pbwarmu017/BIO1015-Homeostasis-Demonstrator/Images/Crank Affector Wiring.jpg

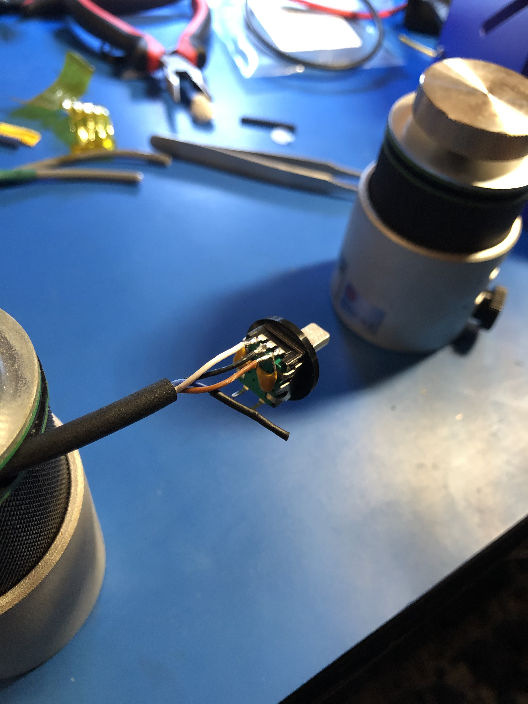
Images/Crank Affector Wiring.jpg
