pbwarmu017/BIO1015-Homeostasis-Demonstrator/Images/handcrank body assembly.jpg

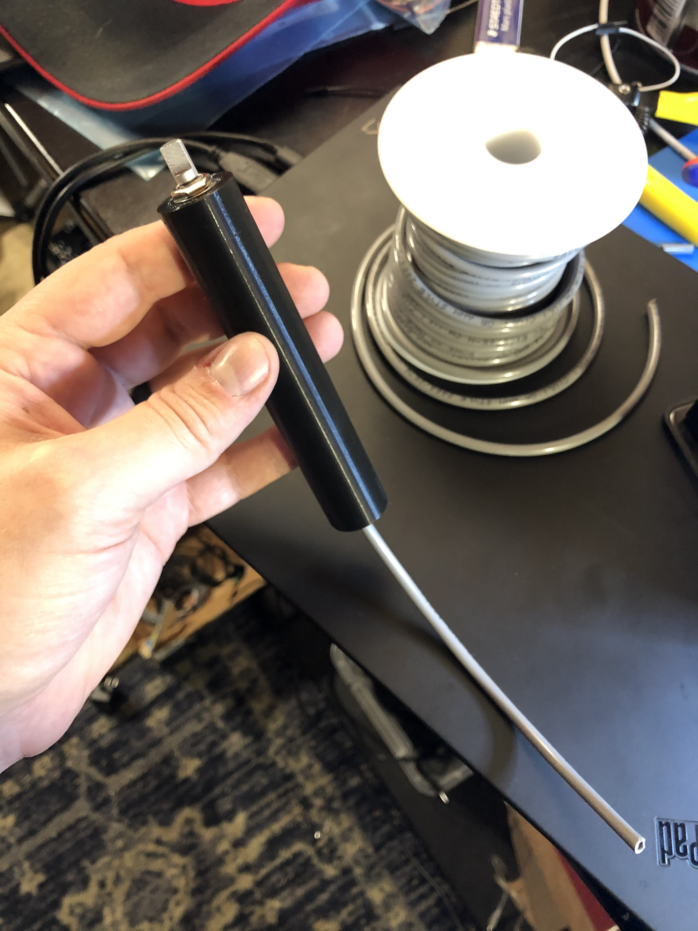
Images/handcrank body assembly.jpg
