pbwarmu017/BIO1015-Homeostasis-Demonstrator/circuits/bitmaps/top.bmp

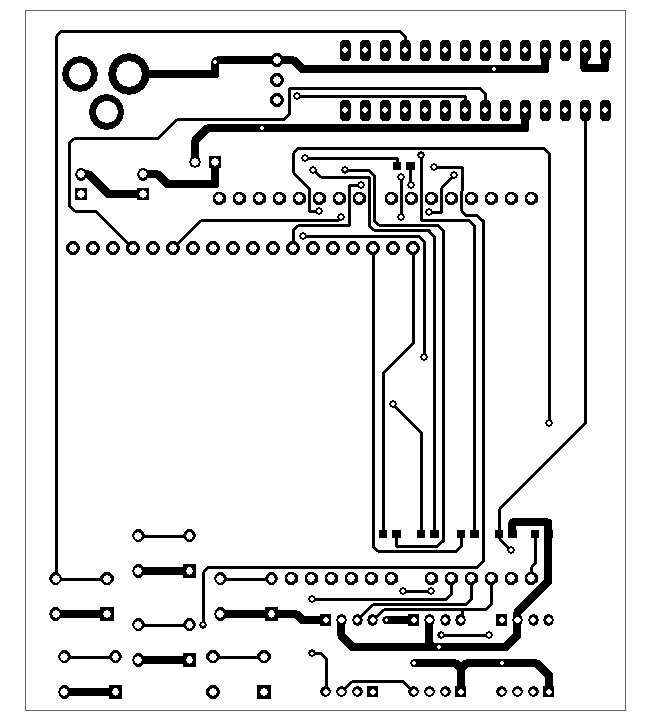
circuits/bitmaps/top.bmp
