pbwarmu017/BIO1015-Homeostasis-Demonstrator/Images/Connector Closeup.jpg

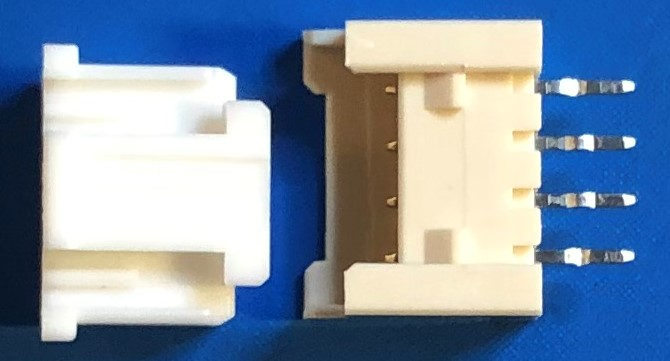
Images/Connector Closeup.jpg
