pbwarmu017/BIO1015-Homeostasis-Demonstrator/Images/Connectors.jpg

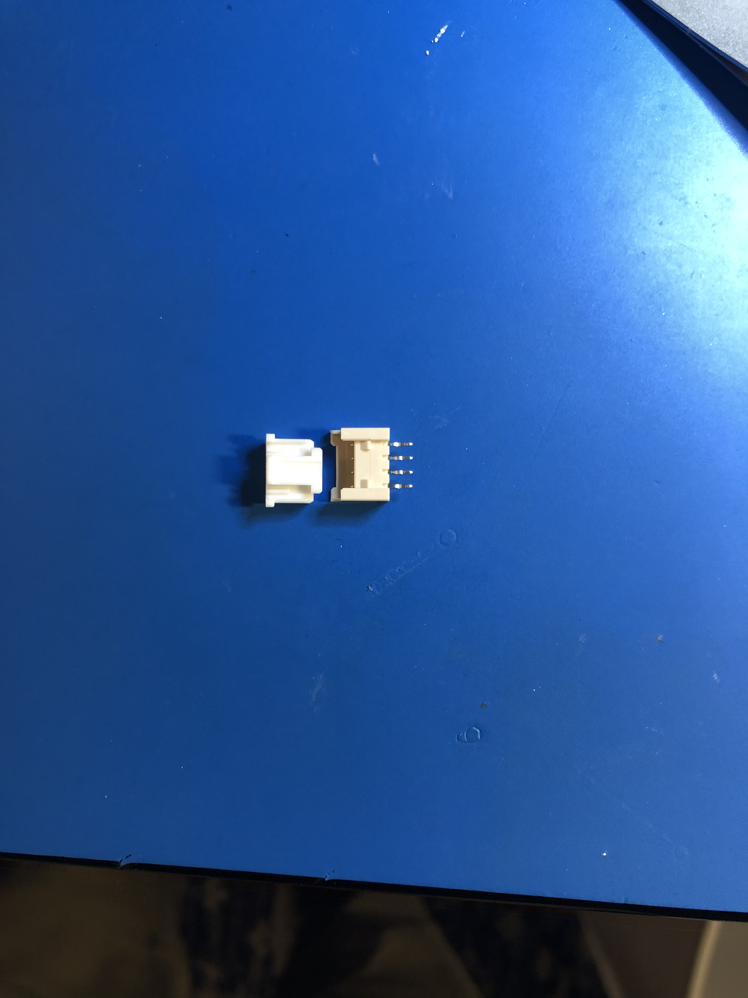
Images/Connectors.jpg
