pbwarmu017/BIO1015-Homeostasis-Demonstrator/Images/Crank Affector.jpg

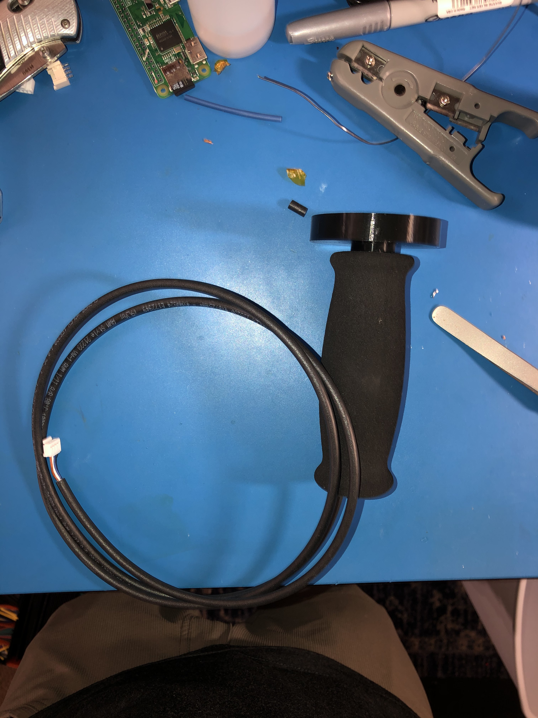
Images/Crank Affector.jpg
