pbwarmu017/BIO1015-Homeostasis-Demonstrator/Images/Grip Affector.jpg

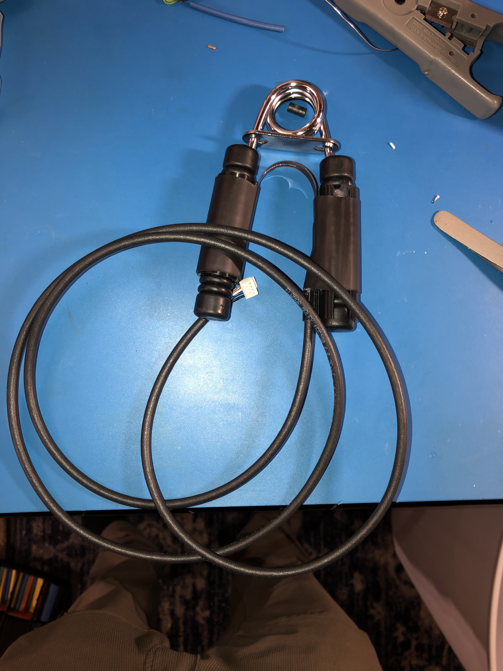
Images/Grip Affector.jpg
