pbwarmu017/BIO1015-Homeostasis-Demonstrator/Images/how caps are connected.jpg

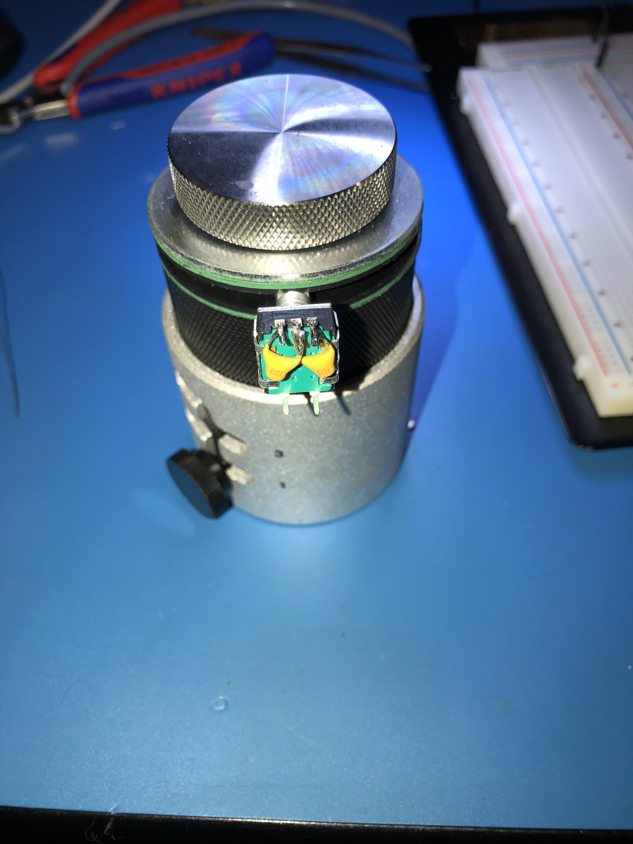
Images/how caps are connected.jpg
