pbwarmu017/BIO1015-Homeostasis-Demonstrator/Images/IMG_1912.JPEG

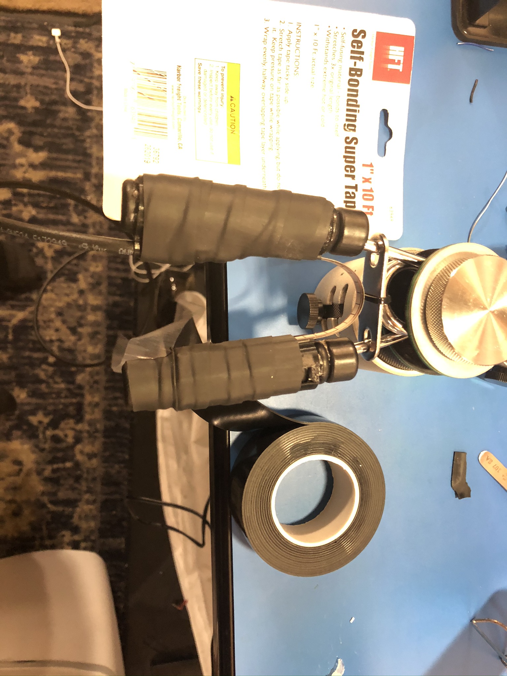
Images/IMG_1912.JPEG
