pbwarmu017/BIO1015-Homeostasis-Demonstrator/Images/IMG_1914.JPEG

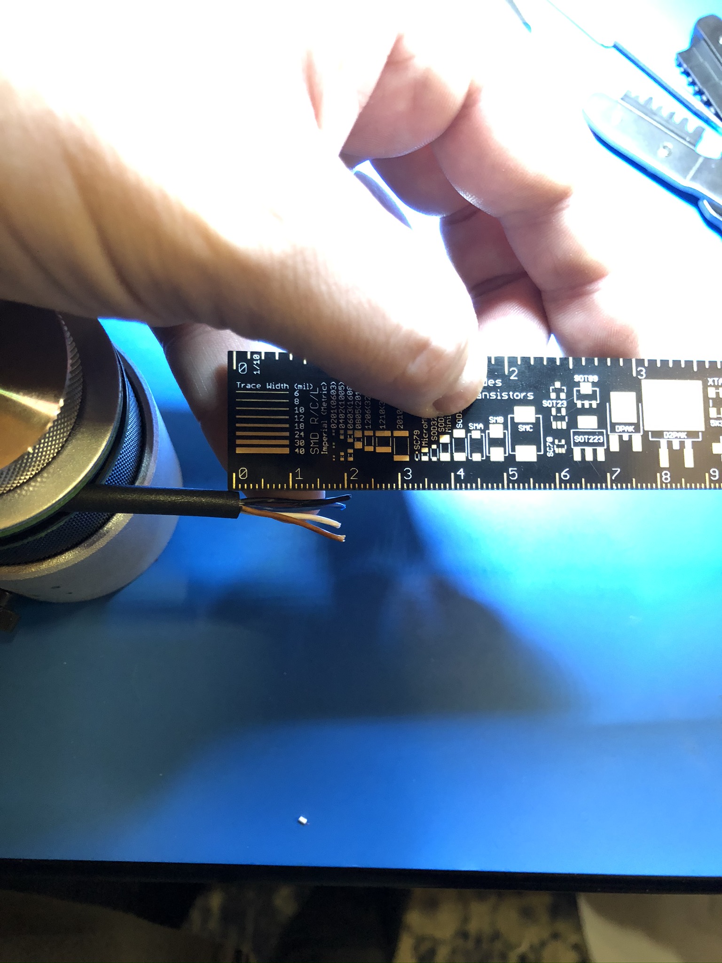
Images/IMG_1914.JPEG
