pbwarmu017/BIO1015-Homeostasis-Demonstrator/3D Models/Main Housing_v2.stl

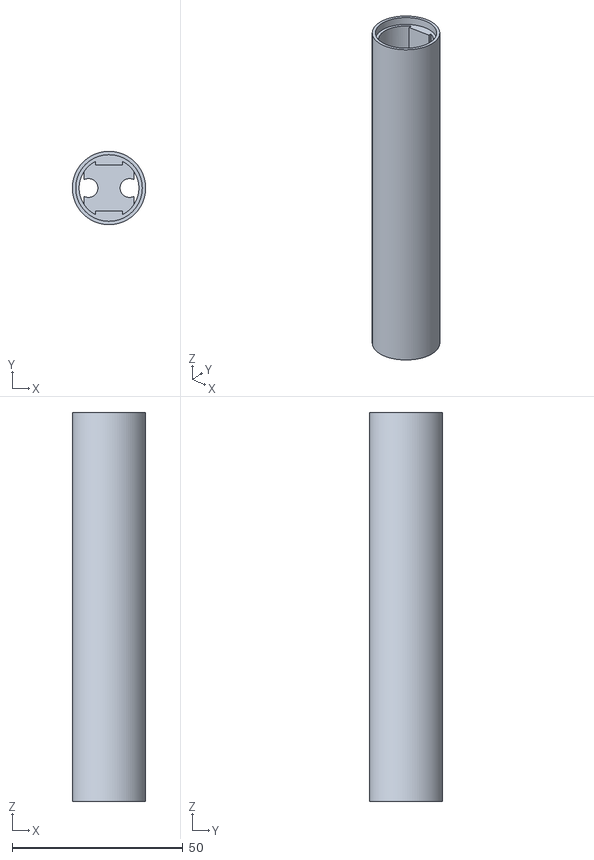
[picture p32: CAD file, 2020-02-03]
3D Models/Main Housing_v2.stl
21.5 x 21.5 x 114.0
