pbwarmu017/BIO1015-Homeostasis-Demonstrator/3D Models/Squeeze Insert w Strain Relief.stl

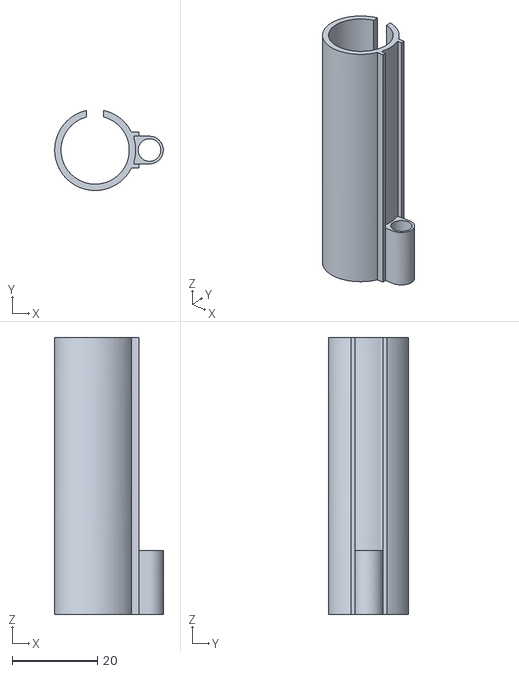
[picture p33: CAD file, 2019-11-03]
3D Models/Squeeze Insert w Strain Relief.stl
25.5 x 18.8 x 65.0
