pbwarmu017/BIO1015-Homeostasis-Demonstrator/3D Models/Squeeze Insert wo Strain Relief.stl

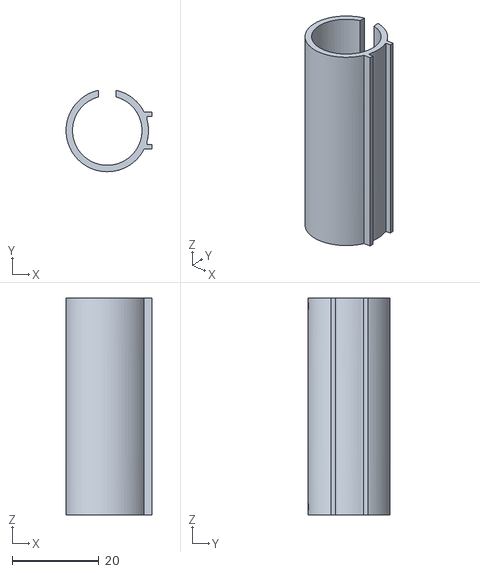
[picture p34: CAD file, 2019-11-03]
3D Models/Squeeze Insert wo Strain Relief.stl
19.8 x 18.8 x 50.0
