pbwarmu017/BIO1015-Homeostasis-Demonstrator/3D Models/HandCrank_v1.stl

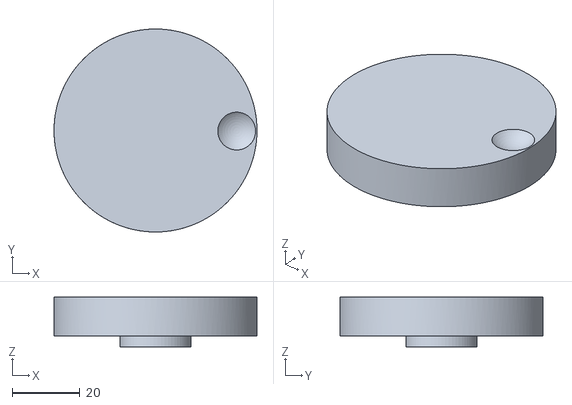
[picture p35: CAD file, 2019-10-15]
3D Models/HandCrank_v1.stl
60.0 x 60.0 x 14.8
