pbwarmu017/BIO1015-Homeostasis-Demonstrator/3D Models/Cover_v1.stl

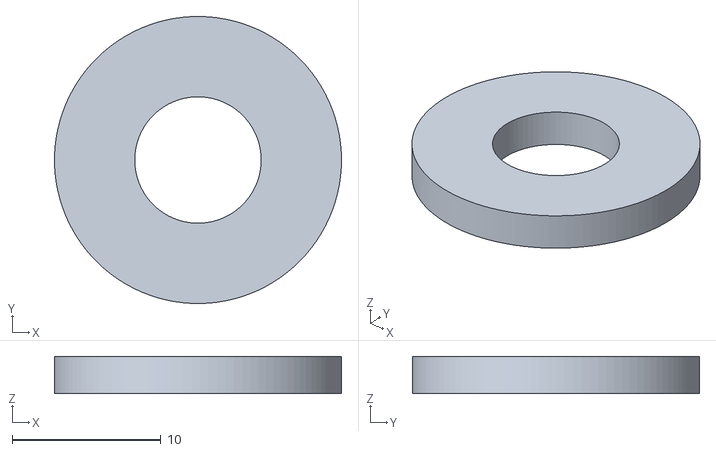
[picture p36: CAD file, 2019-10-13]
3D Models/Cover_v1.stl
19.3 x 19.3 x 2.50
