pbwarmu017/BIO1015-Homeostasis-Demonstrator/3D Models/Main Housing_v1.stl

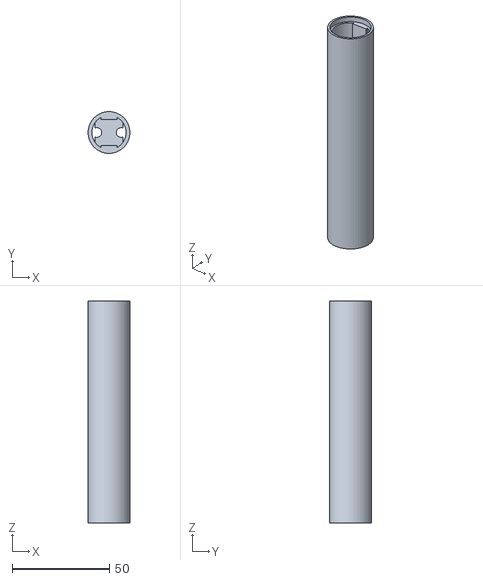
[picture p37: CAD file, 2019-10-13, an earlier design]
3D Models/Main Housing_v1.stl
21.5 x 21.5 x 114.0
