pbwarmu017/BIO1015-Homeostasis-Demonstrator/(threads)

Thread 11 (2019-10-13):

Erratic Interrupts

pbwarmu017, 2019-10-13:
https://github.com/pbwarmu017/BIO1015-Homeostasis-Demonstrator/blob/eec98f19c3d1bf28589ca5f6185262149d05f7ed/multi-effector_homeostasis_device/multi-effector_homeost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

If the code in the interrupt takes longer than 1 millisecond to complete, the interrupt will trigger again before the previous code has finished causing erratic behavior

pbwarmu017, 2019-10-13:
I need to inline the functions called within the interrupts, or  better yet... have the interrupt set a flag that the main loop checks for, and then clear the flag after it is done executing. Right now, the real world behavior of the program depends on how long it takes to execute the code from within the interrupt. If it takes longer than 1 ms, it causes problems. When fourier analysis is incorporated later on, this problem will become painfully evident.

pbwarmu017, 2019-10-14:
Decoupled function calls from the ISRs with commit 6f0d6444185b342927c01342c0557562273669da

Closed 2019-10-14.

Thread 12 (2019-10-13):

Find better cabling

pbwarmu017, 2019-10-13:
The PVC jacket on this wire is stiff, and these parts have to move freely. Find a softer wire that is reasonably priced, perhaps polyurethane?

pbwarmu017, 2019-10-13:
ordered a small sample of this:
https://www.digikey.com/product-detail/en/molex/1552300013/WM21784-1-ND/9094120
Will update later.

Thread 16 (2019-10-13):

Make another prototyping cable

pbwarmu017, 2019-10-13:
Need another one, currently only have one... but I have two affectors and I'd like to use them together.

pbwarmu017, 2019-10-13:
Completed. Made a regular connection cable and added a removable breakout to it.

Closed 2019-10-13.

Thread 3 (2019-10-13):

Hand Crank Design

pbwarmu017, 2019-10-13:
- [x] Verify hardware function (filtering needed)?
- [x] Initial Body Design
- [x] Initial Handle Design
- [x] Initial Cap Design
- [x] Test and refine body
- [x] Test and refine handle
- [x] test and refine cap

pbwarmu017, 2019-10-13:
Hardware filtering is needed. Instituted a low pass filter, and did some clever signal conditioning to debounce.

pbwarmu017, 2019-10-13:
Modified and reprinted body to make cable openings larger. may need to modify again to provide strain relief.

pbwarmu017, 2019-10-13:
Hand crank prototype completed.

Closed 2019-10-13.

Thread 5 (2019-10-13):

Hand Crank Affector

pbwarmu017, 2019-10-13:
- [x] Implement rotary encoder in software
- [x] make max rotation rate 60 hz (per datasheet)
- [x] implement moving average EFFICIENTLY
- [x] standardize the way that rates are calculated in the software to make adding new affectors easier

pbwarmu017, 2019-10-13:
further tuning will be needed in the future one the affector is fully assembled, but for now I am moving on.

Closed 2019-10-13.

Thread 6 (2019-10-13):

Connect and Activate Backlit Display

pbwarmu017, 2019-10-13:
- [x] Reverse Engineer circuit for later use in shield
- [x] wire in display to arduino
- [x] find and implement relevant software packages
- [x] test display RGB backlight
- [x] test display readout
- [x] test display buttons

pbwarmu017, 2019-10-15:
This needs to be done before the shield is manufactured to verify that all the pinouts will work with one another. Once the display is connected, and working along with the other two affectors, then start the work on designing and manufacturing the shield.

Closed 2019-10-27.

Thread 8 (2019-10-13):

Find better wiring that is more flexible.

pbwarmu017, 2019-10-13:
We need more flexible cabling. PVC isn't going to cut it.

pbwarmu017, 2019-10-13:
Ordered some Polyurethane cabling to test. Should be more flexible, but still fit in the connectors that I specified for this project https://www.digikey.com/product-detail/en/molex/1552300013/WM21784-1-ND/9094120

pbwarmu017, 2019-10-27:
The polyurethane cable will work wonderfully.

Closed 2019-10-27.

Thread 18 (2019-10-14):

Turn crank into a spin knob and reinforce it.

pbwarmu017, 2019-10-14:
Reinforce the bottom of the knob so as to limit the moment applied to the encoder when pressure is applied off of its axis. Turn it into a circular spinner with a finger depression.

pbwarmu017, 2019-10-14:
Doing this would also prevent students from misusing the affector.

Closed 2019-10-15.

Thread 21 (2019-10-15):

Handgrip calibration

pbwarmu017, 2019-10-15:
The max and min voltages seem to change every time I set it up. Add in the capability to calibrate the handgrip.

pbwarmu017, 2019-10-15:
now calibrates the high end when the system starts up

Closed 2019-10-15.

Thread 22 (2019-10-15):

design and manufacture shield

pbwarmu017, 2019-10-15:
- [x] Power Arduino and LED strip from DC jack on shield
- [x] Connect LED strip
- [x] Include display
- [x] Include buttons
- [x] Include 2 analog ports
- [x] include 2 digital ports
- [x] passthrough headers
- [x] send to Oshpark

pbwarmu017, 2019-10-26:
Passthrough headers are possible, but I need to find a kit with long legs suited for Arduino.

pbwarmu017, 2019-10-26:
- [ ] Include 2 mixed analog /digital ports

pbwarmu017, 2019-10-26:
Note: the mixed ports share analog pins with the analog ports (see schematic). Because of this, you can use either ACON1 or DACON1, but not both at the same time. The same goes for ACON2 and DACON2. This is due an inherent limitation of Arduino. There are only 4 available analog pins, because I am using two of them for I2C communications.

Closed 2019-11-20.

Thread 30 (2019-11-20):

Modify Sheild

pbwarmu017, 2019-11-20:
Make the following corrections/changes:

- [x] Make LEDSIGNAL and LEDPOWER pinouts match between ground and VCC
- [x] Move labels on affector plugs so they are more visible.
- [x] Move display up to avoid interfering with USB shroud
- [x] remove DC power jack, and make VCC pull from the +5V pin (1 AMP limit, but it will be enough as long as we don't go crazy with the LEDs). Power arduino from 9v supply.

pbwarmu017, 2019-11-23:
I moved the display up as far as I could get away with relative to the sheild's connection to the arduino.

pbwarmu017, 2019-11-23:
ordered new set of PCBs from JLCPCB

Closed 2020-01-20.

Thread 32 (2019-11-20):

Decouple handgrip affector from the LED refresh rate

pbwarmu017, 2019-11-20:
Currently, the handgrip rate is calculated when the LED refreshes. Decouple this and give it its own timer for calculation like the other affectors.

Closed 2020-02-03.

Thread 34 (2019-11-20):

Calibrate range of squeeze affector automatically

pbwarmu017, 2019-11-20:
There’s currently too much variability

<sub>Sent with <a href="http://githawk.com">GitHawk</a></sub>

Closed 2020-02-03.

Thread 42 (2020-02-03):

Fix timing in calibration for squeeze affectors

pbwarmu017, 2020-02-03:
Make it so that holding down select for a little bit of time doesn’t inadvertently complete calibration during the second step.

<sub>Sent with <a href="http://githawk.com">GitHawk</a></sub>

pbwarmu017, 2020-02-11:
Also made it so that you cannot hold the arrow buttons and make the system scroll. One push now equals one screen change.

Closed 2020-02-11.
