pbwarmu017/BIO1015-Homeostasis-Demonstrator/circuits/Schematic_v2.pdf

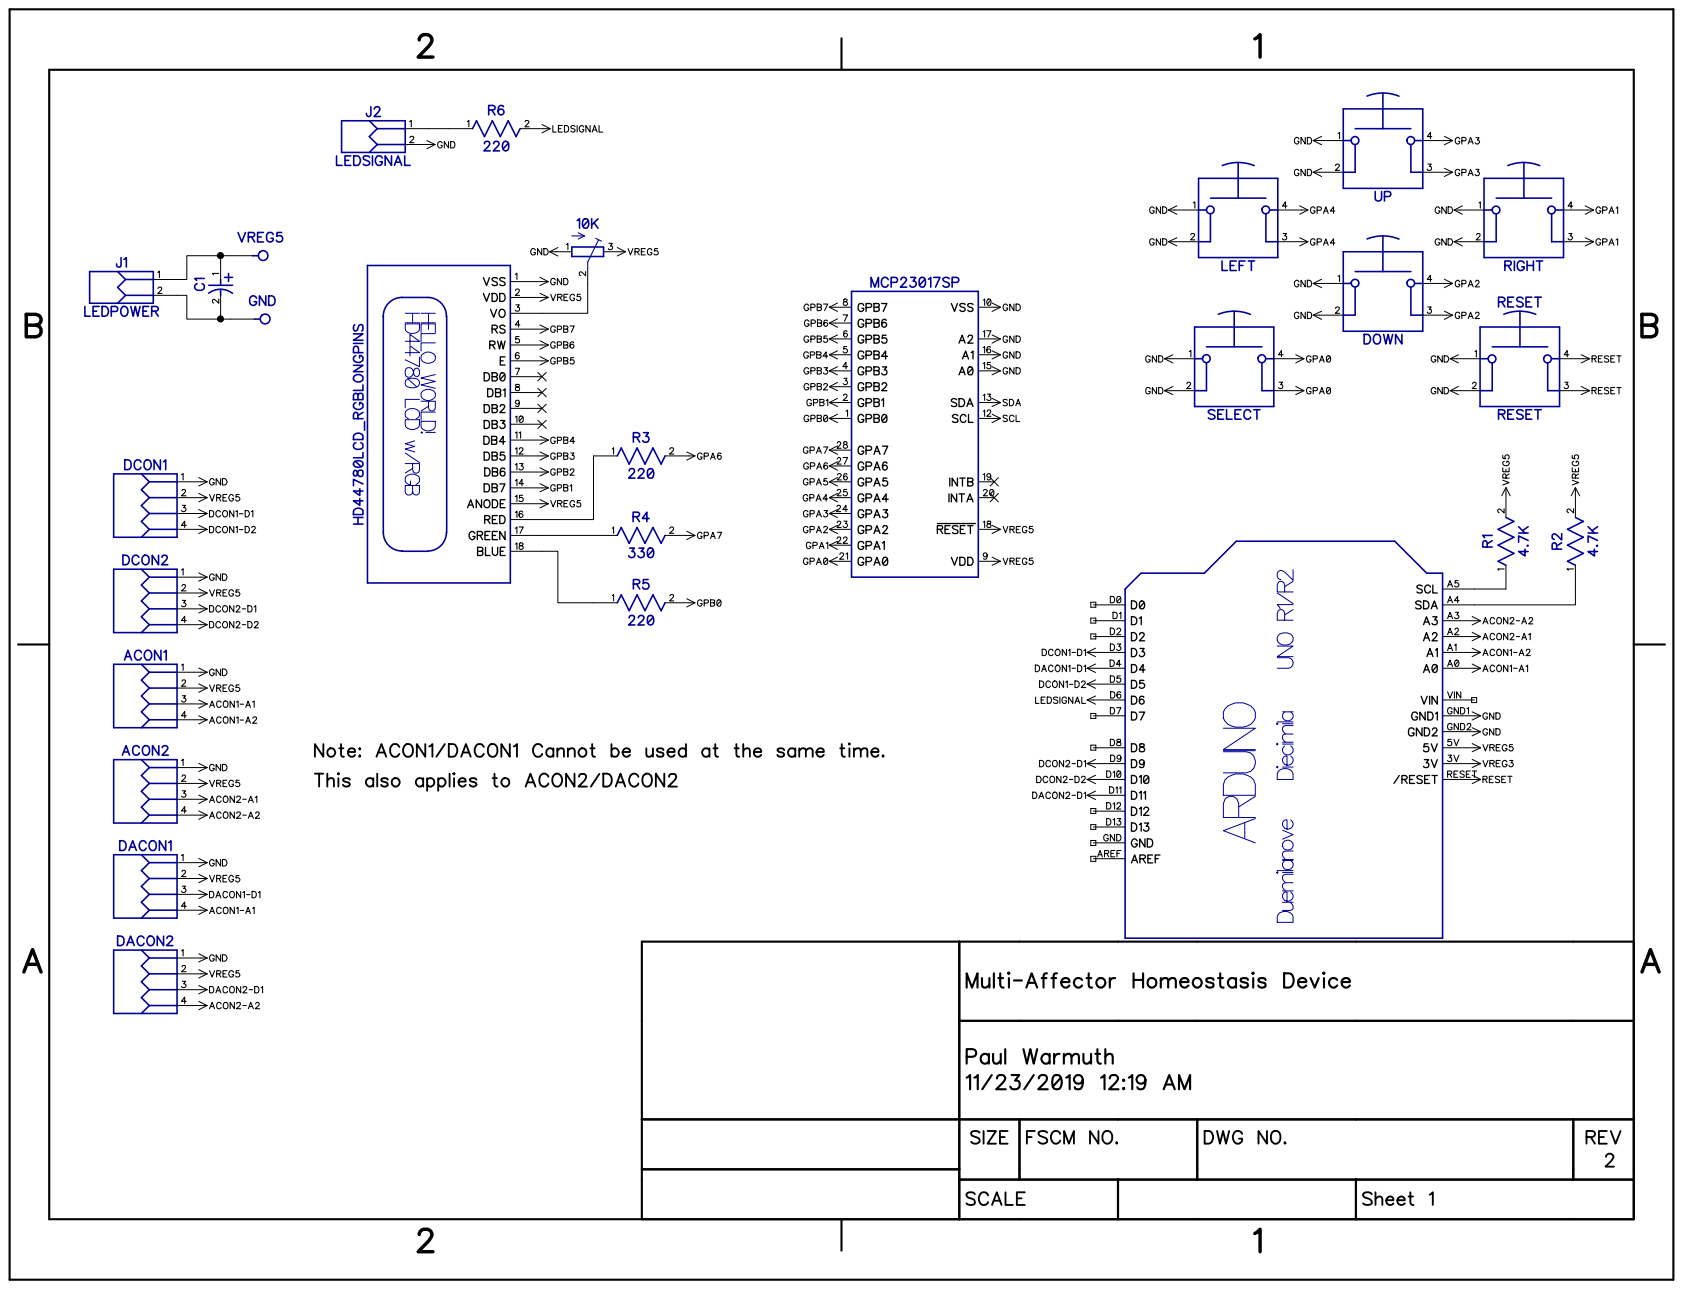
[picture p38: page 1]

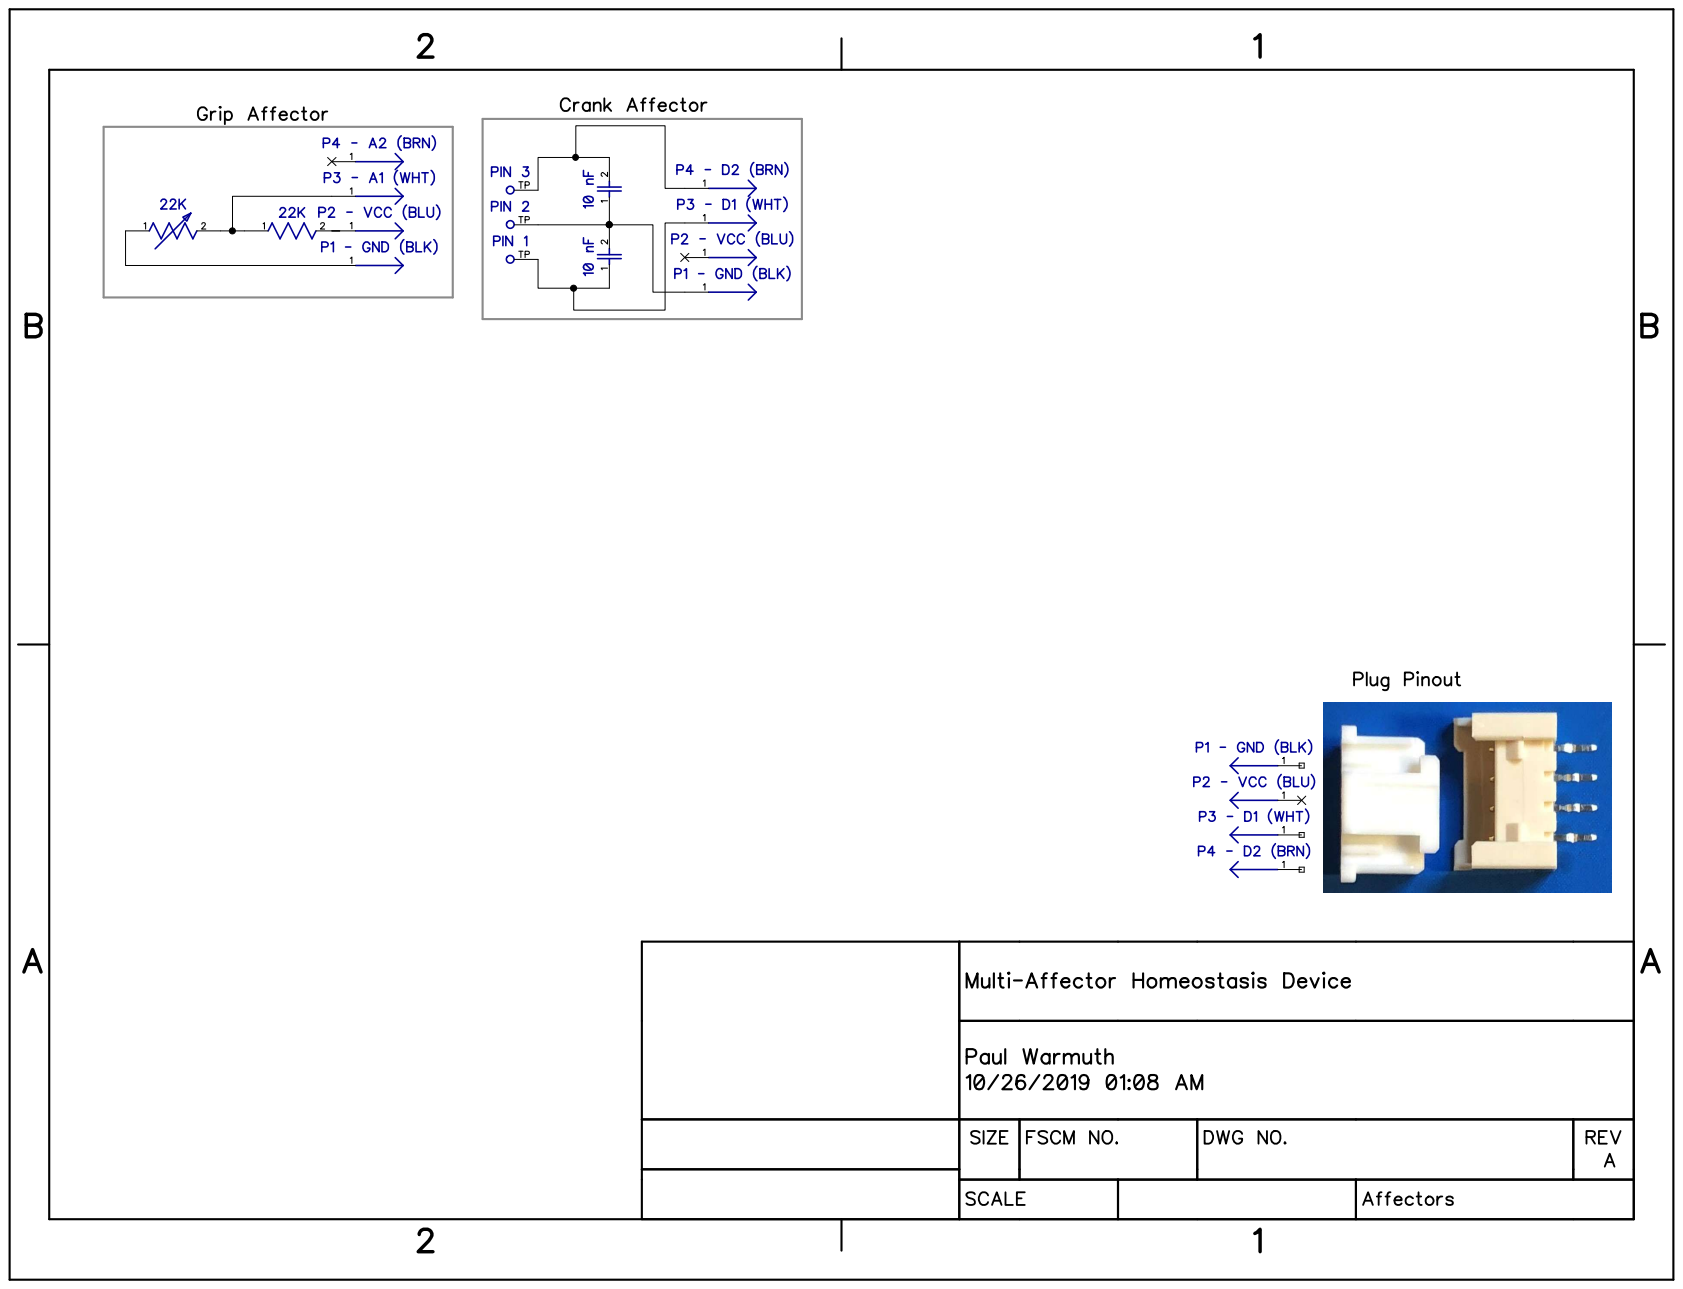
[picture p39: page 2]
