pbwarmu017/BIO1015-Homeostasis-Demonstrator/(list of files, drawings)

Other design files:
circuits/Homeostasis Device Schematic-v2.dch
circuits/PCB Layout_v2_Final.dip
