pbwarmu017/BIO1015-Homeostasis-Demonstrator/(commit log)

2019-10-08 Preparation work for the encoder
2019-10-12 Cleanup
    device numbers are not needed within the handgrip class, because all methods operate on the handgrip
2019-10-12 Added Crank inputs
    Initial code commit to add crank functionality to the homeostasis device. Still needs testing and tuning.
2019-10-12 Minor adjustment
    Adjusted to fit the actual voltage values
2019-10-12 cleanup, standardization, and tuning
    major work to get the hand crank functioning as intended. standardized the way the rates are being fed into the rest of the system. The handcrank functions as intended with this update, though additional tuning needs to be done when the hand-crank itself is produced (3d printed).
2019-10-13 3D Models for hankcrank
    Release Candidate 2 for hand crank. Includes insert, cap, and handle. May need further refinement.
    [Cap RC2.stl, Hand-crank insert v3.f3d, Handle RC2.stl, Main Housing RC2.stl]
2019-10-13 Ignoring .gcode
    GCODE files are tuned for my 3d printer and are useless for others. You must create your own with a slicing program like Simplify3D, Cura etc.
2019-10-13 Modified 3d models
    [Cap RC2.stl, Cover RC3.stl, HandCrank RC3.stl, Handle RC2.stl, Main Housing RC2.stl, Main Housing RC3.stl]
2019-10-13 Initial commit
    Fusion 360 file
    [Hand-crank assembly RC3.f3d]
2019-10-13 Adding File
    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
    [Hand-crank assembly RC3.f3d]
2019-10-13 Updates to the models
    This is the model that has been printed and will be demo'd to Professor Jensen
    [Cover RC3.stl, Cover RC5.stl, Hand-crank assembly RC3.f3d, Hand-crank assembly RC4.f3d, Hand-crank insert v3.f3d, HandCrank RC3.stl, HandCrank RC4.stl]
2019-10-13 3D printer in action
    Building the prototype hand crank
2019-10-13 Added parts list
    Keeping track of what I needed and where I got it.
2019-10-14 Cleanup
    Removed unused variable and prevented the possibility of a negative index being fed to the array.
    [encoder.cpp]
2019-10-14 Bug Fix
    Uncoupled the function calls from the interrupt service routines. This is good coding practice and prevents the interrupt from triggering and calling functions again, while it is in the process of executing them. In general, we want to spend as little time in an interrupt as possible.
    [multi-effector_homeostasis_device.ino]
2019-10-14 Made pin available for the LED strip
2019-10-14 Added logic to reset game after failure condition
    The bounding box will reset to its default 5 seconds after the game has been lost.
    [multi-effector_homeostasis_device.ino]
2019-10-15 Added handgrip calibration step
    On startup, the handgrip max volatge is calibrated. (The handgrip's voltage goes down as you squeeze it) You can modify the sensitivity by increasing the minimum voltage.
2019-10-15 Revert "Just showing M how this works"
    This reverts commit 953adc87d7862e9dbcf8d02334157197a977d731.
    [handgrip.cpp]
2019-10-15 Final Approved models
    [HandCrankRC5.stl, HandCrankRC6.stl]
2019-10-21 Work in Progress
    [Homeostasis Device Schematic.dch]
2019-10-26 Release Version
    [Homeostasis Device Schematic.dch]
2019-10-26 PCB layout for release version
    [PCB Layout.dip]
2019-10-26 Bitmaps for prototyping
    You can use these to print off this PCB at home if you want to give it a go.
2019-10-26 Finished up.
    [Homeostasis Device Schematic.dch]
2019-10-26 Optimized for square inches
    Tried to shrink this down a bit to save money when ordering prototypes.
    [PCB Layout.dip, PCB Layout_space optimized.dip]
2019-10-26 gerbers for the PCB.
    [BoardOutline.gbr, Bottom.gbr, BottomAssy.gbr, BottomDimension.gbr, BottomMask.gbr, BottomPaste.gbr, BottomSilk.gbr, Through.drl]
2019-10-26 Added ANSI title block
    [Homeostasis Device Schematic.dch]
2019-10-26 PDF Schematic
2019-10-26 Added date/time to title block
    [Homeostasis Device Schematic.dch]
2019-10-26 Fixed silkscreen
    [PCB Layout_space optimized.dip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]
2019-10-26 Added 3d model of circuit board
2019-10-27 Improved spacing
    The ports were too close together. Moved to give better access for fingers.
    [PCB Layout_space optimized.dip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]
2019-10-27 Publish v1_final
    These is the versions of the board that is going to be produced.
    [PCB Layout_v1_Final.dip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]
2019-10-27 Updated to 1206 resistors
    Easier to solder by unskilled hands
    [Homeostasis Device Schematic.dch, PCB Layout_v1_Final.dip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]
2019-10-27 Corrected silkscreen
    [PCB Layout_v1_Final.dip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]
2019-11-03 Added affectors and plug pinout to schematic
    [Homeostasis Device Schematic.dch]
2019-11-03 Created insert for better longevity
    Includes cable strain relief and channel for the strain gauge to keep it straight.
    [Squeeze Insert w Strain Relief.stl, Squeeze Insert wo Strain Relief.stl]
2019-11-03 initial LCD functionality
    Refresh rate is slower than expected. :( The I2C conversion takes quite a bit of overhead, apparently... and I2C is slow to begin with.
2020-01-07 Voltage Modification
2020-01-19 moved related #define statements to correct source file
    [lcd.cpp]
2020-01-19 Auto stash before revert of "moved related #define statements to correct source file"
    [lcd.cpp]
2020-01-31 Update to new system
    Encoder and indicator strip are now functioning analogous to what they were before the system changes.
2020-02-01 Tied rate calculations to strip refresh rate
    this prevents timing mismatches from creating undefined behavior. It was manifesting as rate inconsistencies for the affectors on the strip. Currently, strip refresh rate is 20 times per second. This seems to be a good tradeoff between smooth animation and efficiency.
    [encoder.cpp, handgrip.cpp, indicatorstrip.cpp, multi-effector_homeostasis_device.ino]
2020-02-03 New Images
    [Homeostasis Device Schematic-v2.dch, Main Housing_v2.stl]
2020-02-03 Small bugfix and removed negative rage contribution.
    [encoder.cpp]
2020-02-03 Fix value overflow bug
    [multi-effector_homeostasis_device.ino]
2020-02-11 Limited to 2 devices active at once.
2020-02-14 Error handing for unacceptable group activations
    [menu.cpp]
2020-02-16 Revert "Comments, Code Readability, and UI Improvements"
    This reverts commit 22905aaf4ddb4efe6b654df88b172629d05ba483.
    [menu.cpp, superclasses.cpp]
2020-02-16 (Reverted) Comments, Code Readability, and UI Improvements
    [menu.cpp, superclasses.cpp]
2020-02-17 Prevented system mode change while holding select.
    [multi-effector_homeostasis_device.ino]
